unforgiven512/VGAtonic/Hardware_Rev_B/_saved_VGATonic RevB.sch

## KiCad design Hardware_Rev_B/_saved_VGATonic RevB.sch (2018-05-24)

Schematic: _saved_VGATonic RevB.sch

Parts:
C1, C2, C3, C4, C5, C6, C7, C8, C9, C10, C11: 0.1uF; C_0603
C12: 1uF; C_0603
FID1, FID2: CONN_01X01; Fiducial_1mm_Dia_2.54mm_Outer_CopperTop
IC1: ATTINY2313A-S; SOIC-20_7.5x12.8mm_Pitch1.27mm
R1, R3, R4: 10k; R_0805
R2: 4.7k; R_0805
U1: LTC6903; MSOP-8_3x3mm_Pitch0.65mm
U2: XC95144PQ100-100TQFP; TQFP-100_14x14mm_Pitch0.5mm
U3: IS61LV5128AL; tsop2-44

Notes on the sheet:
Decap
Framebuffer Memory
SPI Slave and Display Core
