unforgiven512/VGAtonic/(commit log)

2017-10-28 fix windows filename issue
    [AVR_Composite_NTSC_Firmware.ino, spi.ino, tinydefs.h]
2018-05-24 A large variety of formatting and readability related changes
    [_saved_VGATonic RevB.sch]
